bapshago/928-Signal-Board/hardware/jlcpcb/928-signal-board-rev-a-bom.csv

Comment | Designator | Footprint | LCSC Part # | MPN
47uF 63V | C10 | SMD,D8x10.5mm | C82011 | RVT1J470M0810
100nF 100V | C11 | 0805 | C28233 | CL21B104KCFNNNE
100nF | C2,C12 | 0603 | C14663 | CC0603KRX7R9BB104
10nF | C101,C102,C103,C104,C105,C106,C107,C108,C109,C110,C111,C112,C113,C114,C115,C116 | 0402 | C15195 | CL05B103KB5NNNC
BAT54S | D3 | SOT-23 | C7420333 | BAT54S
SS34 | D10 | SMA | C8678 | SS34
SMBJ24A | D11 | SMB | C5178956 | SMBJ24A
NUP2105L | D12 | SOT-23 | C284104 | NUP2105L
1N4148WS | D101,D102,D103,D104,D105,D106,D107,D108,D109,D110,D111,D112,D113,D114,D115,D116 | SOD-323 | C2128 | 1N4148WS
1A | F1 | 1206 | C151135 | 0466001.NRHF
47kΩ | R4 | 0603 | C25819 | 0603WAF4702T5E
10kΩ | R5,R201,R202,R203,R204,R205,R206,R207,R208,R209,R210,R211,R212,R213,R214,R215,R216 | 0603 | C25804 | 0603WAF1002T5E
120Ω | R10 | 0805 | C54921099 | HRC0805F1200FNTN
2.2kΩ | R101,R102,R103,R104,R105,R106,R107,R108,R109,R110,R111,R112,R113,R114,R115,R116 | 1206 | C2930413 | FRC1206F2201TS
10kΩ | R301,R302,R303,R304,R305,R306,R307,R308,R309,R310,R311,R312,R313,R314,R315,R316 | 0402 | C60490 | RC0402FR-0710KL
SN65HVD230DR | U2 | SOIC-8 | C12084 | SN65HVD230DR
TLP291-4 | U3,U4,U5,U6 | SOIC-16 | C60900 | TLP291-4(GB-TP,E)
