bapshago/928-Signal-Board/hardware/928-signal-board-outline.dxf

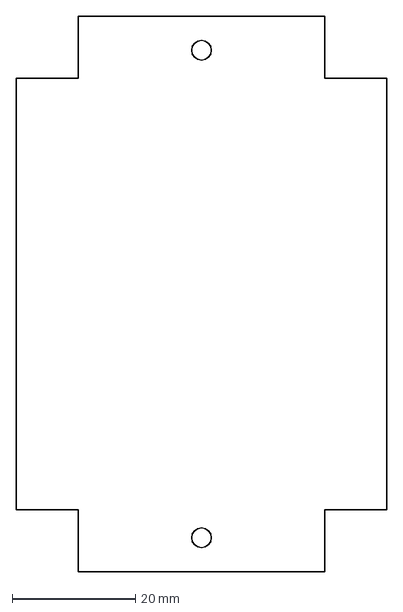
[picture p8: CAD file, 2026-11-01]
hardware/928-signal-board-outline.dxf
60.0 x 90.0 mm
