bapshago/928-Signal-Board/hardware/kicad/928-signal-board.kicad_pcb

## KiCad design hardware/kicad/928-signal-board.kicad_pcb (2026-11-01)

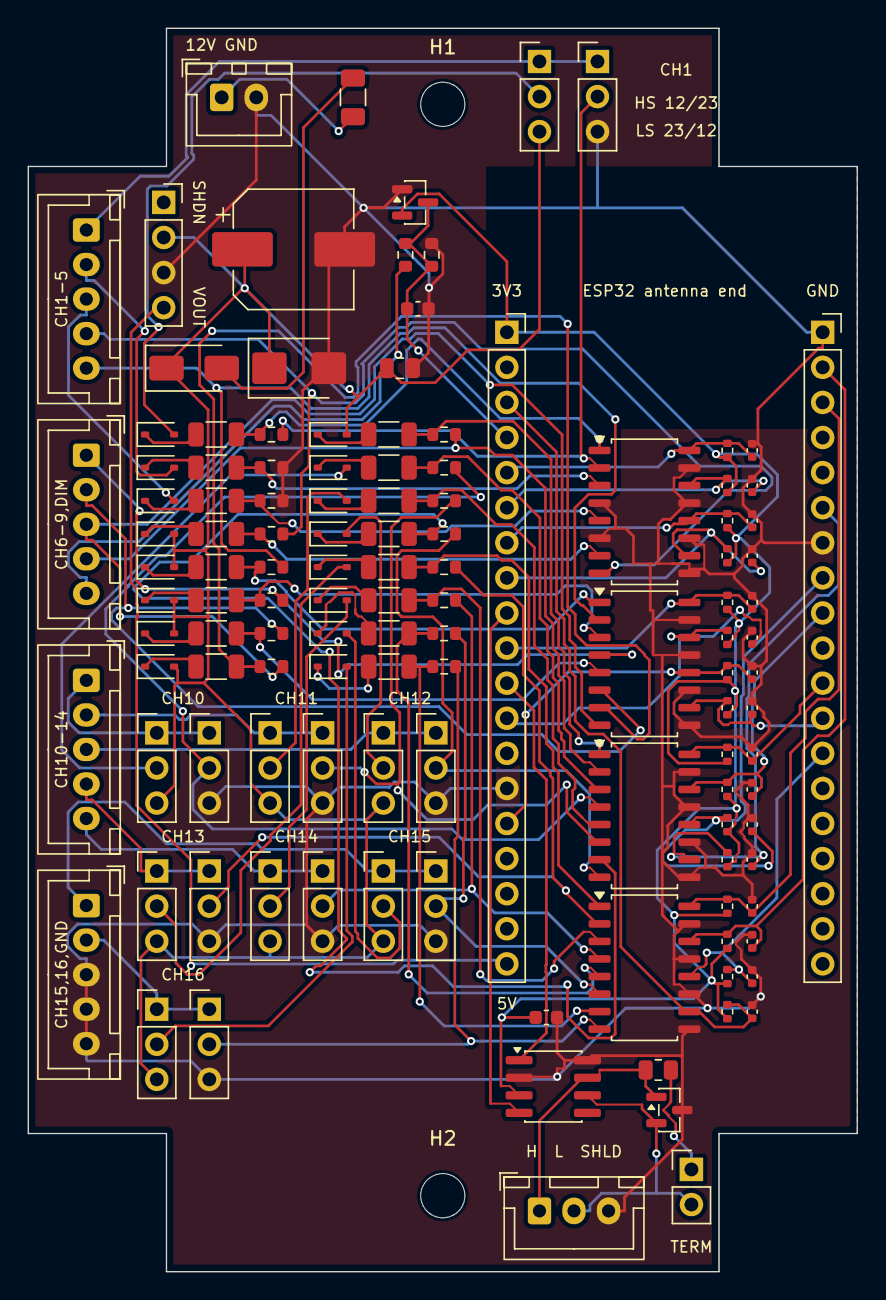
[picture p9: board 928-signal-board.kicad_pcb from above]

Board: 2 copper layers, 60.0 x 90.0 mm, 125 parts (0 on the bottom side), 93 nets.

Parts:
C2, C12: 100n; C_0603_1608Metric
C10: 47u 63V; CP_Elec_8x10.5
C11: 100n 100V; C_0805_2012Metric
C101, C102, C103, C104, C105, C106, C107, C108, C109, C110, C111, C112, C113, C114, C115, C116: 10n; C_0402_1005Metric
D3: BAT54S; SOT-23
D10: SS34; D_SMA
D11: SMBJ24A; D_SMB
D12: NUP2105L; SOT-23
D101, D102, D103, D104, D105, D106, D107, D108, D109, D110, D111, D112, D113, D114, D115, D116: 1N4148WS; D_SOD-323
F1: 1A; Fuse_1206_3216Metric
H1, H2: MountingHole_3.2mm_M3
J1: PWR 3R/9R; JST_XH_B2B-XH-A_1x02_P2.50mm_Vertical
J2: CAN; JST_XH_B3B-XH-A_1x03_P2.50mm_Vertical
J3: Inputs CH1-5; JST_XH_B5B-XH-A_1x05_P2.50mm_Vertical
J4: Inputs CH6-9,DIM; JST_XH_B5B-XH-A_1x05_P2.50mm_Vertical
J5: Inputs CH10-14; JST_XH_B5B-XH-A_1x05_P2.50mm_Vertical
J6: Inputs CH15,16,GND; JST_XH_B5B-XH-A_1x05_P2.50mm_Vertical
J7: DevKitC J2; PinSocket_1x19_P2.54mm_Vertical
J8: DevKitC J3; PinSocket_1x19_P2.54mm_Vertical
J9: Pololu D36V6F5; PinSocket_1x04_P2.54mm_Vertical
JP10: TERM; PinHeader_1x02_P2.54mm_Vertical
JP101: CH1 JP1; PinHeader_1x03_P2.54mm_Vertical
JP110: CH10 JP1; PinHeader_1x03_P2.54mm_Vertical
JP111: CH11 JP1; PinHeader_1x03_P2.54mm_Vertical
JP112: CH12 JP1; PinHeader_1x03_P2.54mm_Vertical
JP113: CH13 JP1; PinHeader_1x03_P2.54mm_Vertical
JP114: CH14 JP1; PinHeader_1x03_P2.54mm_Vertical
JP115: CH15 JP1; PinHeader_1x03_P2.54mm_Vertical
JP116: CH16 JP1; PinHeader_1x03_P2.54mm_Vertical
JP201: CH1 JP2; PinHeader_1x03_P2.54mm_Vertical
JP210: CH10 JP2; PinHeader_1x03_P2.54mm_Vertical
JP211: CH11 JP2; PinHeader_1x03_P2.54mm_Vertical
JP212: CH12 JP2; PinHeader_1x03_P2.54mm_Vertical
JP213: CH13 JP2; PinHeader_1x03_P2.54mm_Vertical
JP214: CH14 JP2; PinHeader_1x03_P2.54mm_Vertical
JP215: CH15 JP2; PinHeader_1x03_P2.54mm_Vertical
JP216: CH16 JP2; PinHeader_1x03_P2.54mm_Vertical
R4: 47k; R_0603_1608Metric
R5, R201, R202, R203, R204, R205, R206, R207, R208, R209, R210, R211, R212, R213, R214, R215, R216: 10k; R_0603_1608Metric
R10: 120; R_0805_2012Metric
R101, R102, R103, R104, R105, R106, R107, R108, R109, R110, R111, R112, R113, R114, R115, R116: 2.2k; R_1206_3216Metric
R301, R302, R303, R304, R305, R306, R307, R308, R309, R310, R311, R312, R313, R314, R315, R316: 10k; R_0402_1005Metric
U2: SN65HVD230DR; SOIC-8_3.9x4.9mm_P1.27mm
U3, U4, U5, U6: TLP291-4; SOIC-16_4.55x10.3mm_P1.27mm

Connections:
+3V3: C12.1, D3.2, J7.1, R301.1, R302.1, R303.1, R304.1, R305.1, R306.1, R307.1, R308.1, R309.1, R310.1, R311.1, R312.1, R313.1, R314.1, R315.1, R316.1, U2.3
+5V: J7.19, J9.4
+12V_FUSED: D10.2, F1.2
+12V_IN: F1.1, J1.1
+12V_SW: C10.1, C11.1, D10.1, D11.1, D104.2, D105.2, D106.2, D107.2, D108.2, D109.2, J9.2, JP101.3, JP110.3, JP111.3, JP112.3, JP113.3, JP114.3, JP115.3, JP116.3
CANH: D12.1, J2.1, R10.1, U2.7
CANL: D12.2, J2.2, JP10.2, U2.6
CAN_RX: J7.9, U2.4
CAN_TERM: JP10.1, R10.2
CAN_TX: J7.11, U2.1
CH1_D1_A: D101.2, JP101.2
CH1_GPIO34: C101.1, J7.5, R301.2, U3.16
CH1_IN: J3.1, JP101.1, JP201.1
CH1_LED_A: R101.2, R201.1, U3.1
CH1_LED_K: JP201.2, R201.2, U3.2
CH2_GPIO35: C102.1, J7.6, R302.2, U3.14
CH2_IN: D102.2, J3.2
CH2_LED_A: R102.2, R202.1, U3.3
CH3_GPIO32: C103.1, J7.7, R303.2, U3.12
CH3_IN: D103.2, J3.3
CH3_LED_A: R103.2, R203.1, U3.5
CH4_GPIO33: C104.1, J7.8, R304.2, U3.10
CH4_IN: J3.4, R204.2, U3.8
CH4_LED_A: R104.2, R204.1, U3.7
CH5_GPIO26: C105.1, J7.10, R305.2, U4.16
CH5_IN: J3.5, R205.2, U4.2
CH5_LED_A: R105.2, R205.1, U4.1
CH6_GPIO14: C106.1, J7.12, R306.2, U4.14
CH6_IN: J4.1, R206.2, U4.4
CH6_LED_A: R106.2, R206.1, U4.3
CH7_GPIO13: C107.1, J7.15, R307.2, U4.12
CH7_IN: J4.2, R207.2, U4.6
CH7_LED_A: R107.2, R207.1, U4.5
CH8_GPIO16: C108.1, J8.12, R308.2, U4.10
CH8_IN: J4.3, R208.2, U4.8
CH8_LED_A: R108.2, R208.1, U4.7
CH9_GPIO17: C109.1, J8.11, R309.2, U5.16
CH9_IN: J4.4, R209.2, U5.2
CH9_LED_A: R109.2, R209.1, U5.1
CH10_D1_A: D110.2, JP110.2
CH10_GPIO18: C110.1, J8.9, R310.2, U5.14
CH10_IN: J5.1, JP110.1, JP210.1
CH10_LED_A: R110.2, R210.1, U5.3
CH10_LED_K: JP210.2, R210.2, U5.4
CH11_D1_A: D111.2, JP111.2
CH11_GPIO19: C111.1, J8.8, R311.2, U5.12
CH11_IN: J5.2, JP111.1, JP211.1
CH11_LED_A: R111.2, R211.1, U5.5
CH11_LED_K: JP211.2, R211.2, U5.6
CH12_D1_A: D112.2, JP112.2
CH12_GPIO21: C112.1, J8.6, R312.2, U5.10
CH12_IN: J5.3, JP112.1, JP212.1
CH12_LED_A: R112.2, R212.1, U5.7
CH12_LED_K: JP212.2, R212.2, U5.8
CH13_D1_A: D113.2, JP113.2
CH13_GPIO22: C113.1, J8.3, R313.2, U6.16
CH13_IN: J5.4, JP113.1, JP213.1
CH13_LED_A: R113.2, R213.1, U6.1
CH13_LED_K: JP213.2, R213.2, U6.2
CH14_D1_A: D114.2, JP114.2
CH14_GPIO23: C114.1, J8.2, R314.2, U6.14
CH14_IN: J5.5, JP114.1, JP214.1
CH14_LED_A: R114.2, R214.1, U6.3
CH14_LED_K: JP214.2, R214.2, U6.4
CH15_D1_A: D115.2, JP115.2
CH15_GPIO4: C115.1, J8.13, R315.2, U6.12
CH15_IN: J6.1, JP115.1, JP215.1
CH15_LED_A: R115.2, R215.1, U6.5
CH15_LED_K: JP215.2, R215.2, U6.6
CH16_D1_A: D116.2, JP116.2
CH16_GPIO36: C116.1, J7.3, R316.2, U6.10
CH16_IN: J6.2, JP116.1, JP216.1
CH16_LED_A: R116.2, R216.1, U6.7
CH16_LED_K: JP216.2, R216.2, U6.8
DIM_ADC: C2.1, D3.3, J7.4, R4.2, R5.1
DIM_IN: J4.5, R4.1
GND: C2.2, C10.2, C11.2, C12.2, C101.2, C102.2, C103.2, C104.2, C105.2, C106.2, C107.2, C108.2, C109.2, C110.2, C111.2, C112.2, C113.2, C114.2, C115.2, C116.2, D3.1, D11.2, D12.3, J1.2, J2.3, J6.3, J6.4, J6.5, J7.14, J8.1, J8.7, J9.3, JP201.3, JP210.3, JP211.3, JP212.3, JP213.3, JP214.3, JP215.3, JP216.3, R5.2, R202.2, R203.2, U2.2, U2.8, U3.4, U3.6, U3.9, U3.11, U3.13, U3.15, U4.9, U4.11, U4.13, U4.15, U5.9, U5.11, U5.13, U5.15, U6.9, U6.11, U6.13, U6.15
unnamed: D101.1, R101.1
unnamed: D102.1, R102.1
unnamed: D103.1, R103.1
unnamed: D104.1, R104.1
unnamed: D105.1, R105.1
unnamed: D106.1, R106.1
unnamed: D107.1, R107.1
unnamed: D108.1, R108.1
unnamed: D109.1, R109.1
unnamed: D110.1, R110.1
unnamed: D111.1, R111.1
unnamed: D112.1, R112.1
unnamed: D113.1, R113.1
unnamed: D114.1, R114.1
unnamed: D115.1, R115.1
unnamed: D116.1, R116.1
