bapshago/928-Signal-Board/(commit log)

2026-11-01 928 Signal Board rev A: hardware, firmware and bench tools
    - hardware/: Gerbers, assembly BOM and CPL for JLCPCB (as used for the first
    boards), the KiCad board, board outline, pin-outs, jumpers, bring-up steps
    - firmware/: ESP32 Arduino sketch with Wi-Fi status and settings pages, OTA
    update and bus-safe CAN, plus a PC test harness
    - tools/: CAN monitor and CAN transceiver test sketches
    - Enclosure notes and photos; CC BY-NC-SA 4.0 license
    [928-signal-board-outline.dxf, 928-signal-board-rev-a-bom.csv, 928-signal-board.kicad_pcb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]
2026-11-01 Hardware README: where the first build's through-hole parts and enclosure came from
2026-11-01 README: cable gland in the lid, as built
2026-11-01 README: the board is installed in the '81 928; link the dash that reads it
2026-11-01 Build photos: JLCPCB viewer, assembled board, Wi-Fi status page, install in the instrument pod
